rhkean/kicad_ESP32-S3_WLED_UnderGlow_Hat/ESP32-S3_WLED_UnderGlow_Hat.kicad_pcb

## KiCad design ESP32-S3_WLED_UnderGlow_Hat.kicad_pcb (2026-06-14)

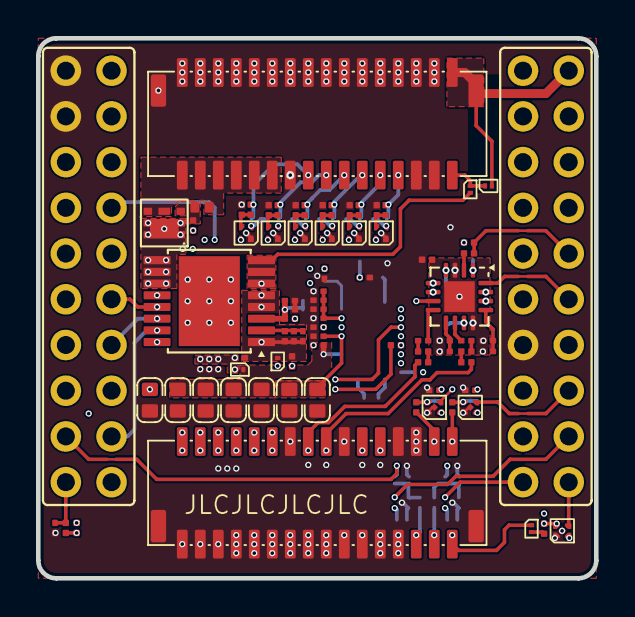
[picture p1: board ESP32-S3_WLED_UnderGlow_Hat.kicad_pcb from above]

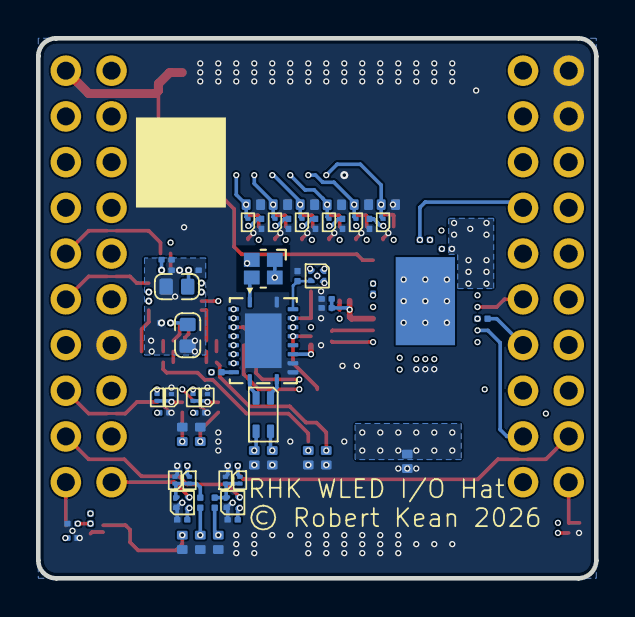
[picture p2: board ESP32-S3_WLED_UnderGlow_Hat.kicad_pcb from below]

Board: 6 copper layers, 31.0 x 30.0 mm, 149 parts (66 on the bottom side), 85 nets.

Parts:
C301, C702, C703, C705, C711, C713, C714, C715, C716, C717, C801, C802, C803, C804, C805, C806, C807, C808, C809, C810, C812, C813, C815, C819, C820, C821, C822, C901, C902, C903, C904, C905, C906, C907, C908, C909, C911, C912, C913, C914, C916: 0.1uF; C_0201_Dense
C701, C704, C706, C707, C708, C709, C710, C811, C816: 22uF; C_0603_Dense
C814, C817, C818: 1uF; C_0201_Dense
C910, C915: 4.7nF; C_0201_Dense
CMC701: CMC 0805; CMC_0805
CN301, CN302: SM32B-NSHDZS-1-TF; JST_NSHD_SM32B-NSHD_2x16_P1.0mm_Horizontal_SMD
D701, D801, D803, D804, D806, D807, D809, D810, D812, D813, D901, D902, D903, D904, D908, D909, D912, D913, D914: PMEG4002ESFYL; DFN0603-2
D702, D703, D815, D816: SZESD7241N2T5G; DFN1006-2
D704, D802, D805, D808, D811, D814, D905, D906, D907, D910, D911, D915, D916: D15V0H1U2LP-7B; DFN1006-2
Q901: NTLJS17D0P03P8Z; WDFN6-4_2.05x2.05mm_P0.65mm
R301, R302, R701, R704, R805, R811, R904, R905, R907, R908, R912, R913, R914, R917, R918: 5k1; R_0201_Dense
R702, R807, R808, R809, R810, R812, R901, R902, R903, R906, R910, R911, R915, R916: 33R; R_0201_Dense
R703, R806: 470R; R_0201_Dense
R801, R802, R803, R804: 26k1; R_0201_Dense
R813: 0R; R_0201_Dense
R909: 100k; R_0201_Dense
U301: ESP32-S3_D1_Pico
U701: TCAN4550-Q1; Texas_RGY_R-PVQFN-N20_EP2.05x3.05mm
U702, U801, U802, U803, U804, U805, U901, U902, U904, U905, U906, U907: 74LV1T125; X2SON5_SOT1226_0.8x0.8mm
U806: ES7241D; QFN-16-1EP_3x3mm_P0.5mm_EP1.7x1.7mm
U903: TPS2HCS10A-Q1; Texas_HTSSOP-16-1EP_5.0x4.4mm_P0.65mm_EP5.0x3.4mm_Mask3.313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
Y701: 40MHz; Oscillator_SMD_Abracon_ASAAIG-4Pin_2.0x1.6mm

Connections:
+3V3: C701.1, C702.1, C711.1, C717.1, C801.1, C802.1, C803.1, C804.1, C805.1, C811.1, C812.1, C813.1, C814.1, C815.1, C816.1, R301.2, R701.2, R811.2, R901.1, U301.8 (+3V3_{out}), U301.18 (+3V3), U701.17 (V_{IO}), U702.2 (A), U702.5 (VCC), U801.5 (VCC), U802.5 (VCC), U803.5 (VCC), U804.5 (VCC), U805.5 (VCC), U806.1 (V_{DD}P), U806.4 (V_{DD}D), U806.11 (V_{DD}A), U806.14 (M1), U806.15 (M0), Y701.1 (EN), Y701.4 (Vdd)
+5V_{FUSED}: C806.1, C807.1, C808.1, C809.1, C901.1, C902.1, C903.1, C904.1, C905.1, D801.1 (K), D804.1 (K), D807.1 (K), D810.1 (K), D902.1 (K), D903.1 (K), D908.1 (K), D909.1 (K), D913.1 (K), D914.1 (K), R805.2, U301.9 (+5V_{FUSED_{out}}), U901.5 (VCC), U902.5 (VCC), U904.5 (VCC), U905.5 (VCC), U906.5 (VCC), U907.5 (VCC)
+V_{BAT}: C907.1, C908.1, C909.1, C910.1, CN302.1, CN302.3, CN302.5, CN302.7, CN302.9, CN302.11, D701.2 (A), D704.1 (K), U903.EP (V_{BB})
+V_{SW}: CN301.21, CN301.23, CN301.25 (Pin_23), CN301.27 (Pin_23), CN301.29 (Pin_23), CN301.31 (Pin_23), D907.1 (K), Q901.3 (S), Q901.4 (S)
/IO_Board/AUX_{L}: CN302.15, D815.1 (A1), R807.2
/IO_Board/AUX_{R}: CN302.17, D816.1 (A1), R810.2
/IO_Board/Brake: U301.39 (IO16), U802.4 (Y)
/IO_Board/Brake_{IN}: CN302.28 (Pin_24), D805.1 (K), R802.2
/IO_Board/CAN Bus/+V_{SUP}: C705.1, C707.1, C708.1, C709.1, C710.1, D701.1 (K), U701.14 (V_{SUP})
/IO_Board/CAN Bus/CAN_F_N: CMC701.2, U701.10 (CANL)
/IO_Board/CAN Bus/CAN_F_P: CMC701.1, U701.11 (CANH)
/IO_Board/CAN Bus/FLTR: C713.1, C714.1, C715.1, C716.1, U701.18 (FLTR)
/IO_Board/CAN Bus/GPO2: R703.2, U701.9 (GPO2)
/IO_Board/CAN Bus/OSC1: U701.1 (OSC1), Y701.3 (OUT)
/IO_Board/CAN Bus/RST: R704.2, U701.19 (RST), U702.4 (Y)
/IO_Board/CAN Bus/SDO: R702.1, U701.6 (SDO)
/IO_Board/CAN Bus/V_{CC_{OUT}}: C703.1, C704.1, C706.1, U701.16 (V_{CCOUT})
/IO_Board/CAN_N: CMC701.3, CN302.23, D702.1 (A1)
/IO_Board/CAN_P: CMC701.4, CN302.21, D703.1 (A1)
/IO_Board/Data1: CN301.17, D902.2 (A), D905.1 (K), R902.1
/IO_Board/Data2: CN301.15, D903.2 (A), D906.1 (K), R903.1
/IO_Board/Data3: CN301.13, D908.2 (A), D910.1 (K), R910.1
/IO_Board/Data4: CN301.11, D909.2 (A), D911.1 (K), R911.1
/IO_Board/Data5: CN301.9, D913.2 (A), D915.1 (K), R915.1
/IO_Board/Data6: CN301.7, D914.2 (A), D916.1 (K), R916.1
/IO_Board/FSPI_{CLK}: U301.6 (FSPI_{CLK}), U701.4 (SCLK), U903.16 (SCLK)
/IO_Board/FSPI_{MISO}: R702.2, R906.2, U301.17 (FSPI_{MISO})
/IO_Board/FSPI_{MOSI}: U301.16 (FSPI_{MOSI}), U701.5 (SDI), U903.13 (SDI)
/IO_Board/GR86 Inputs/A_{IN}L: C817.2, U806.8 (A_{IN}L)
/IO_Board/GR86 Inputs/A_{IN}R: C818.2, U806.10 (A_{IN}R)
/IO_Board/GR86 Inputs/Brake_F: D804.2 (A), D806.1 (K), R802.1, U802.2 (A)
/IO_Board/GR86 Inputs/GND3: C811.2, C812.2, C813.2, C814.2, C815.2, C816.2, C819.2, C820.2, C821.2, C822.2, R813.1, U806.3 (GND_{D}), U806.12 (GND_{A}), U806.17 (GND_{P})
/IO_Board/GR86 Inputs/LTurn_F: D810.2 (A), D812.1 (K), R804.1, U804.2 (A)
/IO_Board/GR86 Inputs/RC_{808-817}: C817.1, R808.1
/IO_Board/GR86 Inputs/RC_{809-818}: C818.1, R809.1
/IO_Board/GR86 Inputs/REF_{P}: C819.1, C820.1, U806.13 (REF_{P})
/IO_Board/GR86 Inputs/REF_{Q}: C821.1, C822.1, U806.9 (REF_{Q})
/IO_Board/GR86 Inputs/RR_{807-808}: R807.1, R808.2
/IO_Board/GR86 Inputs/RR_{809-810}: R809.2, R810.1
/IO_Board/GR86 Inputs/RTurn_F: D807.2 (A), D809.1 (K), R803.1, U803.2 (A)
/IO_Board/GR86 Inputs/Rev_F: D801.2 (A), D803.1 (K), R801.1, U801.2 (A)
/IO_Board/GR86 Inputs/SD_{OUT}: R812.2, U806.2 (SD_{OUT})
/IO_Board/GR86 Inputs/~Dome_F: C810.1, R805.1, R806.2, U805.2 (A)
/IO_Board/I^{2}S_{MCLK}: U301.36 (I^{2}S_{MCLK}), U806.16 (MCLK)
/IO_Board/I^{2}S_{SCK}: U301.26 (I^{2}S_{SCK}), U806.5 (SCLK)
/IO_Board/I^{2}S_{SD}: R811.1, R812.1, U301.35 (I^{2}S_{SD})
/IO_Board/I^{2}S_{WS}: U301.37 (I^{2}S_{WS}), U806.6 (LRCK)
/IO_Board/LED1: U301.32 (IO44), U901.2 (A)
/IO_Board/LED2: U301.23 (IO43), U902.2 (A)
/IO_Board/LED3: U301.33 (IO42), U904.2 (A)
/IO_Board/LED4: U301.24 (IO40), U905.2 (A)
/IO_Board/LED5: U301.34 (IO41), U906.2 (A)
/IO_Board/LED6: U301.25 (IO38), U907.2 (A)
/IO_Board/LTurn: U301.29 (IO17), U804.4 (Y)
/IO_Board/LTurn_{IN}: CN302.29 (Pin_23), D811.1 (K), R804.2
/IO_Board/RLY+: CN301.1, D901.1 (K), D904.1 (K)
/IO_Board/RTurn: U301.38 (IO18), U803.4 (Y)
/IO_Board/RTurn_{IN}: CN302.31 (Pin_23), D808.1 (K), R803.2
/IO_Board/Reverse: U301.30 (IO08), U801.4 (Y)
/IO_Board/Reverse_{IN}: CN302.30 (Pin_24), D802.1 (K), R801.2
/IO_Board/WD: U301.13 (IO02), U701.3 (GPIO1)
/IO_Board/WLED Outputs/LED1_{Buf}: R902.2, R904.1, U901.4 (Y)
/IO_Board/WLED Outputs/LED2_{Buf}: R903.2, R905.1, U902.4 (Y)
/IO_Board/WLED Outputs/LED3_{Buf}: R910.2, R912.1, U904.4 (Y)
/IO_Board/WLED Outputs/LED4_{Buf}: R911.2, R913.1, U905.4 (Y)
/IO_Board/WLED Outputs/LED5_{Buf}: R915.2, R917.1, U906.4 (Y)
/IO_Board/WLED Outputs/LED6_{Buf}: R916.2, R918.1, U907.4 (Y)
/IO_Board/WLED Outputs/SDO: R906.1, U903.14 (SDO)
/IO_Board/WLED Outputs/SNS: C915.1, R907.1, R908.1, U903.2 (SNS)
/IO_Board/WLED Outputs/VDD_{HSS}: C911.1, C912.1, C913.1, C914.1, R901.2, U903.3 (V_{DD})
/IO_Board/WLED Outputs/V_{GATE}: D907.2 (A), Q901.2 (G), R909.2
/IO_Board/WLED Outputs/V_{OUT1}: C906.1, D901.2 (A), U903.6 (V_{OUT1}), U903.7 (V_{OUT1}), U903.8 (V_{OUT1})
/IO_Board/WLED Outputs/V_{OUT2}: C916.1, Q901.1 (D), U903.9 (V_{OUT2}), U903.10 (V_{OUT2}), U903.11 (V_{OUT2})
/IO_Board/~CS_{CAN}: U301.20 (I005), U701.7 (~CS)
/IO_Board/~CS_{HSS}: U301.19 (IO06), U903.15 (~CS)
/IO_Board/~Dome_{IN}: CN302.32 (Pin_24), D813.1 (K), D814.1 (K)
/IO_Board/~Dome: U301.40 (IO15), U805.4 (Y)
/IO_Board/~FLT_{BUS}: R301.1, R302.2, U701.8 (~INT), U903.12 (FLT)
/IO_Board/~FLT_{GBL}: C301.1, R302.1, U301.10 (IO07)
/IO_Board/~Reset Node: R703.1, U301.11 (EN/~RST), U702.1 (OE), U806.7 (~Reset)
/IO_Board/~Wake: R701.1, U301.14 (IO04), U701.2 (~WKRQ)
GND: C301.2, C701.2, C702.2, C703.2, C704.2, C705.2, C706.2, C707.2, C708.2, C709.2, C710.2, C711.2, C713.2, C714.2, C715.2, C716.2, C717.2, C801.2, C802.2, C803.2, C804.2, C805.2, C806.2, C807.2, C808.2, C809.2, C810.2, C901.2, C902.2, C903.2, C904.2, C905.2, C907.2, C908.2, C909.2, C911.2, C912.2, C913.2, C914.2, CN301.3, CN301.4, CN301.5, CN301.6, CN301.8, CN301.10, CN301.12, CN301.14, CN301.16, CN301.18, CN301.19, CN301.20, CN301.22, CN301.24, CN301.26 (Pin_24), CN301.28 (Pin_24), CN301.30 (Pin_24), CN301.32 (Pin_24), CN301.MP2 (MountPin), CN302.2, CN302.4, CN302.6, CN302.8, CN302.10, CN302.12, CN302.13, CN302.14, CN302.16, CN302.18, CN302.19, CN302.20, CN302.22, CN302.24, CN302.25 (Pin_23), CN302.26 (Pin_24), CN302.27 (Pin_23), CN302.MP1 (MountPin), CN302.MP2 (MountPin), D702.2 (A2), D703.2 (A2), D704.2 (A), D802.2 (A), D803.2 (A), D805.2 (A), D806.2 (A), D808.2 (A), D809.2 (A), D811.2 (A), D812.2 (A), D814.2 (A), D815.2 (A2), D816.2 (A2), D905.2 (A), D906.2 (A), D910.2 (A), D911.2 (A), D912.1 (K), D915.2 (A), D916.2 (A), R704.1, R813.2, R904.2, R905.2, R912.2, R913.2, R914.2, R917.2, R918.2, U301.1 (GND), U301.2 (GND), U301.27 (GND), U701.12 (WAKE), U701.13 (GND), U701.20 (OSC2), U701.21 (GND), U702.3 (GND), U801.1 (OE), U801.3 (GND), U802.1 (OE), U802.3 (GND), U803.1 (OE), U803.3 (GND), U804.1 (OE), U804.3 (GND), U805.1 (OE), U805.3 (GND), U901.1 (OE), U901.3 (GND), U902.1 (OE), U902.3 (GND), U904.1 (OE), U904.3 (GND), U905.1 (OE), U905.3 (GND), U906.1 (OE), U906.3 (GND), U907.1 (OE), U907.3 (GND), Y701.2 (GND)
GND0: CN301.2, CN301.MP1 (MountPin), D904.2 (A), U301.31 (GND0)
GND2: C906.2, C910.2, C915.2, C916.2, D912.2 (A), R907.2, R908.2, R909.1, R914.1, U903.1 (GND), U903.4 (DI), U903.5 (LHI)
unnamed: D813.2 (A), R806.1
