rhkean/kicad_ESP32-S3_WLED_UnderGlow_Hat/(commit log)

2026-05-03 removed SPI_and_GBL_FLT.kicad_sch
    [SPI_and_GBL_FLT.kicad_sch]
2026-05-05 Update .gitignore, CANBus_Interface.kicad_sch, ESP32-S3_WLED_UnderGlow_Hat-2026-05-04_233126.zip, and 17 more files
    [CANBus_Interface.kicad_sch, ESP32-S3_WLED_UnderGlow_Hat.kicad_pcb, ESP32-S3_WLED_UnderGlow_Hat.kicad_sch, GR86_Inputs.kicad_sch, IO_Board.kicad_sch, SPI_and_GBL_FLT.kicad_sch, WLED_Outputs.kicad_sch]
2026-05-05 replaced Device:C with Device:C_Small and Device:R with Device:R_Small
    [CANBus_Interface.kicad_sch, GR86_Inputs.kicad_sch, IO_Board.kicad_sch, WLED_Outputs.kicad_sch]
2026-05-05 Updated Net Names for FSPI and I2S nets
    [ESP32-S3_WLED_UnderGlow_Hat.kicad_sch, GR86_Inputs.kicad_sch, IO_Board.kicad_sch, WLED_Outputs.kicad_sch]
2026-05-05 Update .gitignore, ESP32-S3_WLED_UnderGlow_Hat-2026-05-05_083139.zip, ESP32-S3_WLED_UnderGlow_Hat.kicad_pcb, and 1 more file
    [ESP32-S3_WLED_UnderGlow_Hat.kicad_pcb, GR86_Inputs.kicad_sch]
2026-05-06 schematic updated with new ESP32-S3_D1_Pico symbol
    [CANBus_Interface.kicad_sch, ESP32-S3_WLED_UnderGlow_Hat.kicad_pcb, ESP32-S3_WLED_UnderGlow_Hat.kicad_sch, IO_Board.kicad_sch, WLED_Outputs.kicad_sch]
2026-05-06 updated pcb with new ESP32-S3_D1_Pico footprint
    [ESP32-S3_WLED_UnderGlow_Hat.kicad_pcb]
2026-05-06 1mm fillets
    [ESP32-S3_WLED_UnderGlow_Hat.kicad_pcb]
2026-05-07 added ESP32-S3 D1 Pico symbol and footprint
    [IO_Board.kicad_sch]
2026-05-07 Created new edge cut
    [ESP32-S3_WLED_UnderGlow_Hat.kicad_pcb]
2026-06-14 JLCPCB: W2026061412450502 2026-06-14 PCB: Y62-5297522A PCBA: SMT026061460215-5297522A
    [BOM-ESP32-S3_WLED_UnderGlow_Hat.csv, CANBus_Interface.kicad_sch, ESP32-S3_WLED_UnderGlow_Hat.kicad_pcb, ESP32-S3_WLED_UnderGlow_Hat.kicad_sch, GR86_Inputs.kicad_sch, IO_Board.kicad_sch, WLED_Outputs.kicad_sch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]
2026-06-14 Update .gitignore, ESP32-S3_WLED_UnderGlow_Hat-2026-05-04_233126.zip, ESP32-S3_WLED_UnderGlow_Hat-2026-05-04_233720.zip, and 3 more files
