rhkean/kicad_ESP32-S3_WLED_UnderGlow_Hat/(notices)

Notices in the files:
ESP32-S3_WLED_UnderGlow_Hat.kicad_pcb:
© Robert Kean 2026
